Autonomous-Motorsports-Purdue/AMP_PCBv3/(threads)

Thread 2 (2024-04-02):

E-brake motor driver

benjamin-owen, 2024-04-02:
Replace with assembly-compatible part

benjamin-owen, 2024-04-03:
Fixed

Closed 2024-04-03.

Thread 3 (2024-04-02):

Steering

benjamin-owen, 2024-04-02:
Add level shifter for 3.3V-5V logic (see smart air hockey table)

benjamin-owen, 2024-04-03:
Fixed

Closed 2024-04-03.

Thread 4 (2024-04-02):

LEDs

benjamin-owen, 2024-04-02:
Add level shifter for 3.3V-5V logic (see smart air hockey table)

benjamin-owen, 2024-04-03:
Fixed

Closed 2024-04-03.

Thread 6 (2024-04-12):

Remove JLCPCB assembly holes

benjamin-owen, 2024-04-12:
It seems JLC put their own holes on the PCB anyway even though I had already added them, so there is no reason to leave them on the PCB for future orders.

Closed 2024-04-15.

Thread 7 (2024-04-12):

Replace inductor

benjamin-owen, 2024-04-12:
Since JLC doesn't have the SMD power inductor we are using in stock, and we have the room, might as well replace with a large THT inductor for ease of soldering in the future.

benjamin-owen, 2024-04-15:
Due to part availability this isn't feasible.

Closed 2024-04-15.

Thread 10 (2024-04-14):

EBRAKE "+" label wrong?

benjamin-owen, 2024-04-14:
The "+" for EBRAKE might be wrong.  Honestly, can probably just remove it and fix in the EBRAKE driver.

Closed 2024-04-15.

Thread 21 (2024-05-23):

VESC UART driver

benjamin-owen, 2024-05-23:
Good luck (need to reverse engineer VESC code to figure out correct UART commands)
