Autonomous-Motorsports-Purdue/AMP_PCBv3/hardware/AMP_PCBv3.kicad_pcb

## KiCad design hardware/AMP_PCBv3.kicad_pcb (2024-04-04)

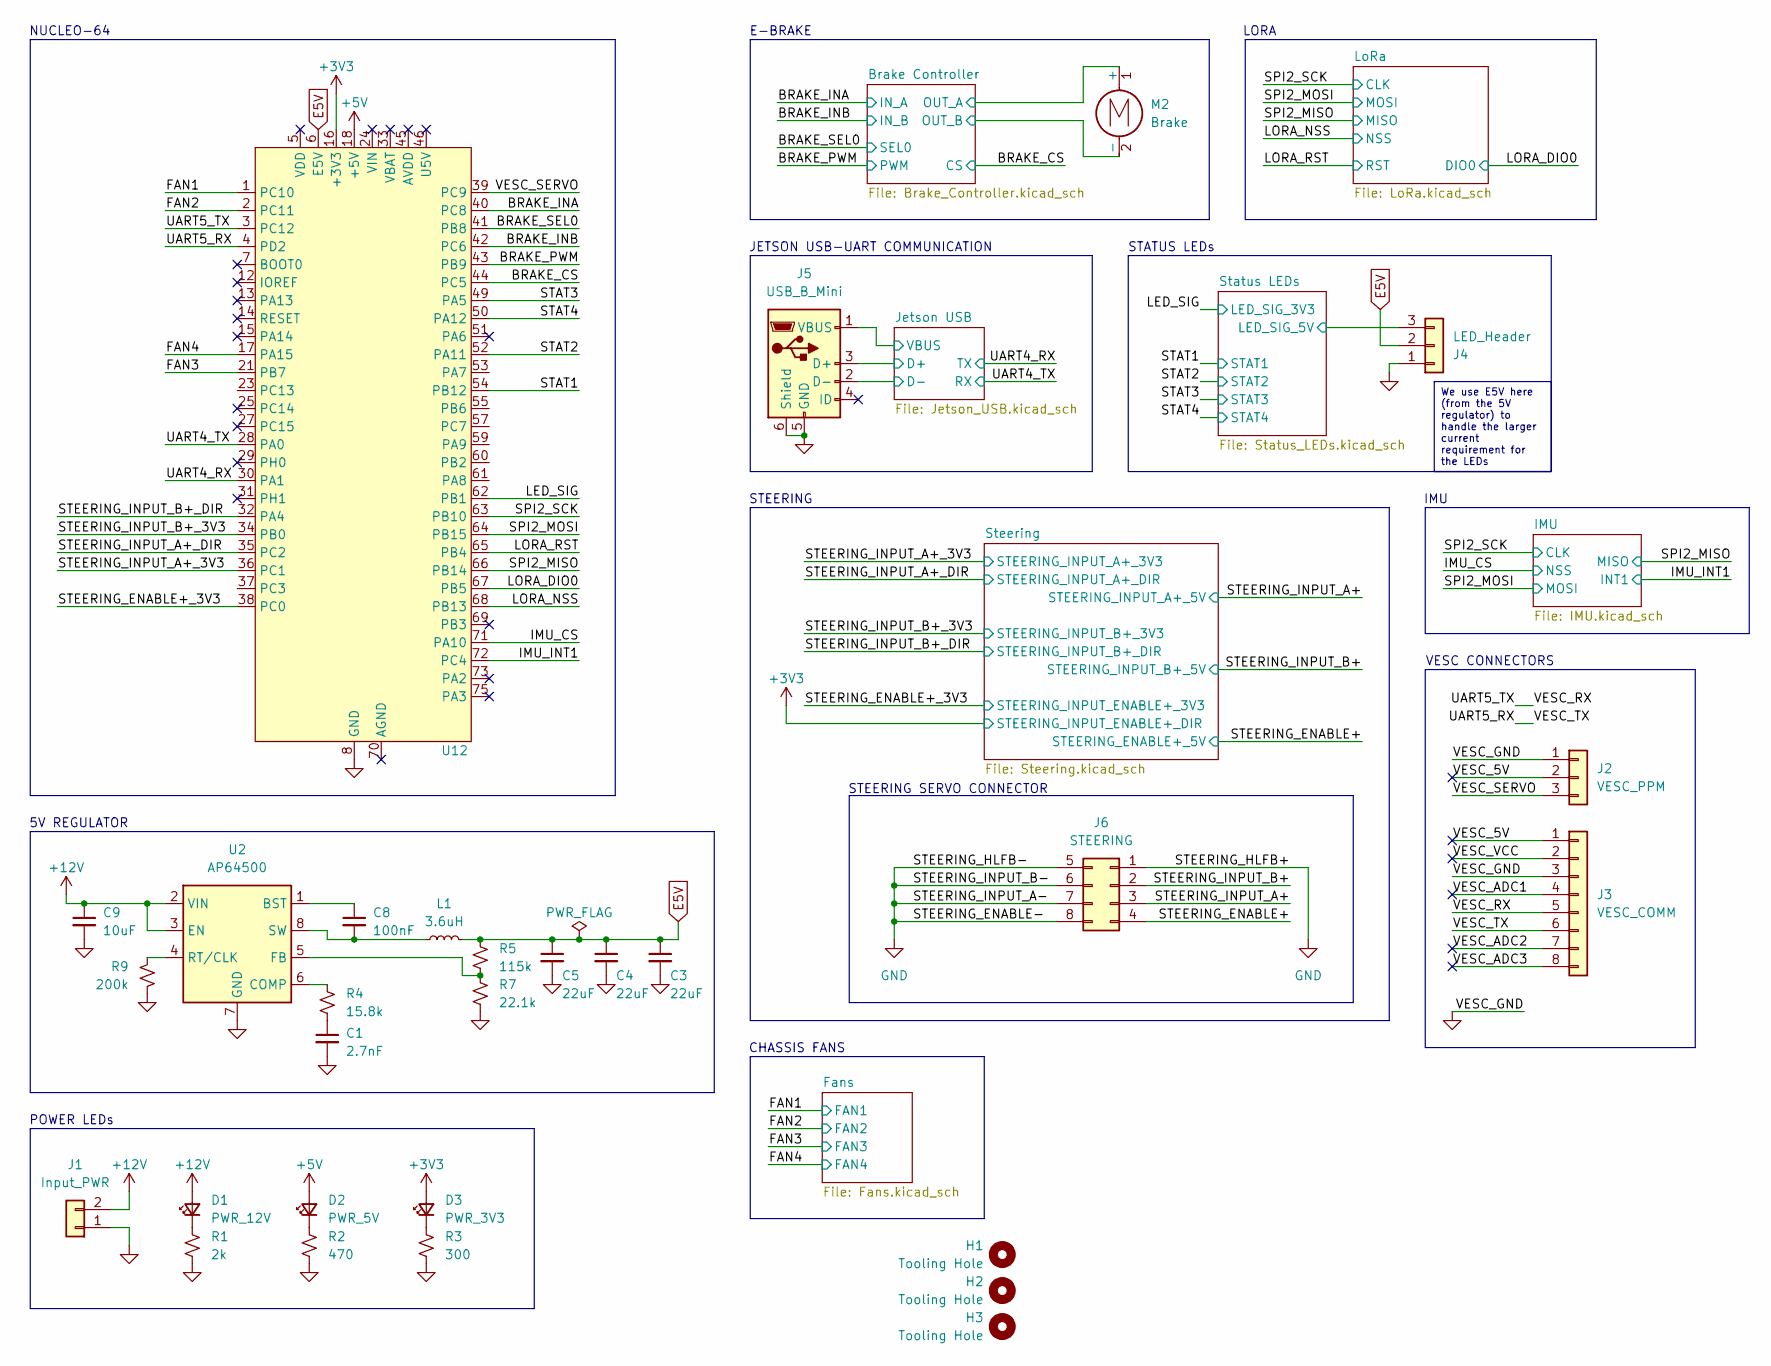
[picture p4: schematic AMP_PCBv3.kicad_sch, AMP PCBv3]

Parts:
C1: 2.7nF; C_0805_2012Metric_Pad1.18x1.45mm_HandSolder; MPN CL21B272KBANNNC
C3, C4, C5: 22uF; C_0805_2012Metric_Pad1.18x1.45mm_HandSolder; JLC C45783
C8: 100nF; C_0805_2012Metric_Pad1.18x1.45mm_HandSolder; JLC C49678
C9: 10uF; C_0805_2012Metric_Pad1.18x1.45mm_HandSolder; JLC C15850
D1: PWR_12V; LED_0805_2012Metric_Pad1.15x1.40mm_HandSolder; JLC C2297
D2: PWR_5V; LED_0805_2012Metric_Pad1.15x1.40mm_HandSolder; JLC C2297
D3: PWR_3V3; LED_0805_2012Metric_Pad1.15x1.40mm_HandSolder; JLC C2297
H1, H2, H3: Tooling Hole; JLCPCB_Tooling_Hole
J1: Input_PWR; Molex_Mini-Fit_Jr_5566-02A_2x01_P4.20mm_Vertical; MPN 0039281023
J2: VESC_PPM; JST_PH_B3B-PH-K_1x03_P2.00mm_Vertical; MPN B3B-PH-K-S
J3: VESC_COMM; JST_PH_B8B-PH-K_1x08_P2.00mm_Vertical; MPN B8B-PH-K-S
J4: LED_Header; Molex_KK-254_AE-6410-03A_1x03_P2.54mm_Vertical; MPN 0022272031
J5: USB_B_Mini; USB_Mini-B_Adam_Tech_MUSB-B5-S-VT-02_Vertical_CircularHoles; MPN MUSB-B5-S-VT-02
J6: STEERING; Molex_Mini-Fit_Jr_5566-08A_2x04_P4.20mm_Vertical; MPN 0039281083
L1: 3.6uH; L_Bourns-SRN8040_8x8.15mm; MPN SRN8040-3R6Y
M2: Brake; Molex_Mini-Fit_Jr_5566-02A_2x01_P4.20mm_Vertical; MPN 0039281023
R1: 2k; R_0805_2012Metric_Pad1.20x1.40mm_HandSolder; JLC C17604
R2: 470; R_0805_2012Metric_Pad1.20x1.40mm_HandSolder; JLC C17710
R3: 300; R_0805_2012Metric_Pad1.20x1.40mm_HandSolder; JLC C17617
R4: 15.8k; R_0805_2012Metric_Pad1.20x1.40mm_HandSolder; MPN RK73H2ATTD1582F
R5: 115k; R_0805_2012Metric_Pad1.20x1.40mm_HandSolder; MPN RC0805FR-07115KL
R7: 22.1k; R_0805_2012Metric_Pad1.20x1.40mm_HandSolder; MPN RMCF0805FT22K1
R9: 200k; R_0805_2012Metric_Pad1.20x1.40mm_HandSolder; JLC C17539
U2: AP64500; Diodes_SO-8EP; JLC C2070920
U12: NUCLEO64

Connections:
+3V3: D3.2 (A), U12.16 (+3V3); also elsewhere on the board
+5V: D2.2 (A), U12.18 (+5V); also elsewhere on the board
+12V: C9.1, D1.2 (A), J1.2, U2.2 (VIN), U2.3 (EN); also elsewhere on the board
/BRAKE_CS: U12.44 (PC5); also elsewhere on the board
/BRAKE_INA: U12.40 (PC8); also elsewhere on the board
/BRAKE_INB: U12.42 (PC6); also elsewhere on the board
/BRAKE_PWM: U12.43 (PB9); also elsewhere on the board
/BRAKE_SEL0: U12.41 (PB8); also elsewhere on the board
/Brake Controller/OUT_A: M2.1 (+); also elsewhere on the board
/Brake Controller/OUT_B: M2.2 (-); also elsewhere on the board
/FAN1: U12.1 (PC10); also elsewhere on the board
/FAN2: U12.2 (PC11); also elsewhere on the board
/FAN3: U12.21 (PB7); also elsewhere on the board
/FAN4: U12.17 (PA15); also elsewhere on the board
/IMU_CS: U12.71 (PA10); also elsewhere on the board
/IMU_INT1: U12.72 (PC4); also elsewhere on the board
/Jetson USB/D+: J5.3 (D+); also elsewhere on the board
/Jetson USB/D-: J5.2 (D-); also elsewhere on the board
/Jetson USB/VBUS: J5.1 (VBUS); also elsewhere on the board
/LED_SIG: U12.62 (PB1); also elsewhere on the board
/LORA_DIO0: U12.67 (PB5); also elsewhere on the board
/LORA_NSS: U12.68 (PB13); also elsewhere on the board
/LORA_RST: U12.65 (PB4); also elsewhere on the board
/SPI2_MISO: U12.66 (PB14); also elsewhere on the board
/SPI2_MOSI: U12.64 (PB15); also elsewhere on the board
/SPI2_SCK: U12.63 (PB10); also elsewhere on the board
/STAT1: U12.54 (PB12); also elsewhere on the board
/STAT2: U12.52 (PA11); also elsewhere on the board
/STAT3: U12.49 (PA5); also elsewhere on the board
/STAT4: U12.50 (PA12); also elsewhere on the board
/STEERING_ENABLE+: J6.4; also elsewhere on the board
/STEERING_ENABLE+_3V3: U12.38 (PC0); also elsewhere on the board
/STEERING_INPUT_A+: J6.3; also elsewhere on the board
/STEERING_INPUT_A+_3V3: U12.36 (PC1); also elsewhere on the board
/STEERING_INPUT_A+_DIR: U12.35 (PC2); also elsewhere on the board
/STEERING_INPUT_B+: J6.2; also elsewhere on the board
/STEERING_INPUT_B+_3V3: U12.34 (PB0); also elsewhere on the board
/STEERING_INPUT_B+_DIR: U12.32 (PA4); also elsewhere on the board
/Status LEDs/LED_SIG_5V: J4.3; also elsewhere on the board
/UART4_RX: U12.30 (PA1); also elsewhere on the board
/UART4_TX: U12.28 (PA0); also elsewhere on the board
/UART5_RX: J3.6, U12.4 (PD2)
/UART5_TX: J3.5, U12.3 (PC12)
/VESC_5V: J2.2, J3.1
/VESC_ADC1: J3.4
/VESC_ADC2: J3.7
/VESC_ADC3: J3.8
/VESC_SERVO: J2.3, U12.39 (PC9)
/VESC_VCC: J3.2
E5V: C3.1, C4.1, C5.1, J4.2, L1.2, R5.1, U12.6 (E5V); also elsewhere on the board
GND: C1.2, C3.2, C4.2, C5.2, C9.2, J1.1, J2.1, J3.3, J4.1, J5.5 (GND), J5.6 (Shield), J6.1, J6.5, J6.6, J6.7, J6.8, R1.2, R2.2, R3.2, R7.2, R9.1, U2.7 (GND), U2.9 (GND), U12.8 (GND), U12.19 (GND), U12.20 (GND), U12.22 (GND), U12.47 (GND), U12.58 (GND); also elsewhere on the board
unnamed: C1.1, R4.1
unnamed: D1.1 (K), R1.1
unnamed: D2.1 (K), R2.1
unnamed: D3.1 (K), R3.1
unnamed: C8.1, U2.1 (BST)
unnamed: R4.2, U2.6 (COMP)
unnamed: R5.2, R7.1, U2.5 (FB)
unnamed: R9.2, U2.4 (RT/CLK)
unnamed: C8.2, L1.1, U2.8 (SW)

Notes on the sheet:
We use E5V here (from the 5V regulator) to handle the larger current requirement for the LEDs
NUCLEO-64
LORA
STEERING SERVO CONNECTOR
E-BRAKE
5V REGULATOR
STEERING
STATUS LEDs
VESC CONNECTORS
POWER LEDs
IMU
CHASSIS FANS
JETSON USB-UART COMMUNICATION

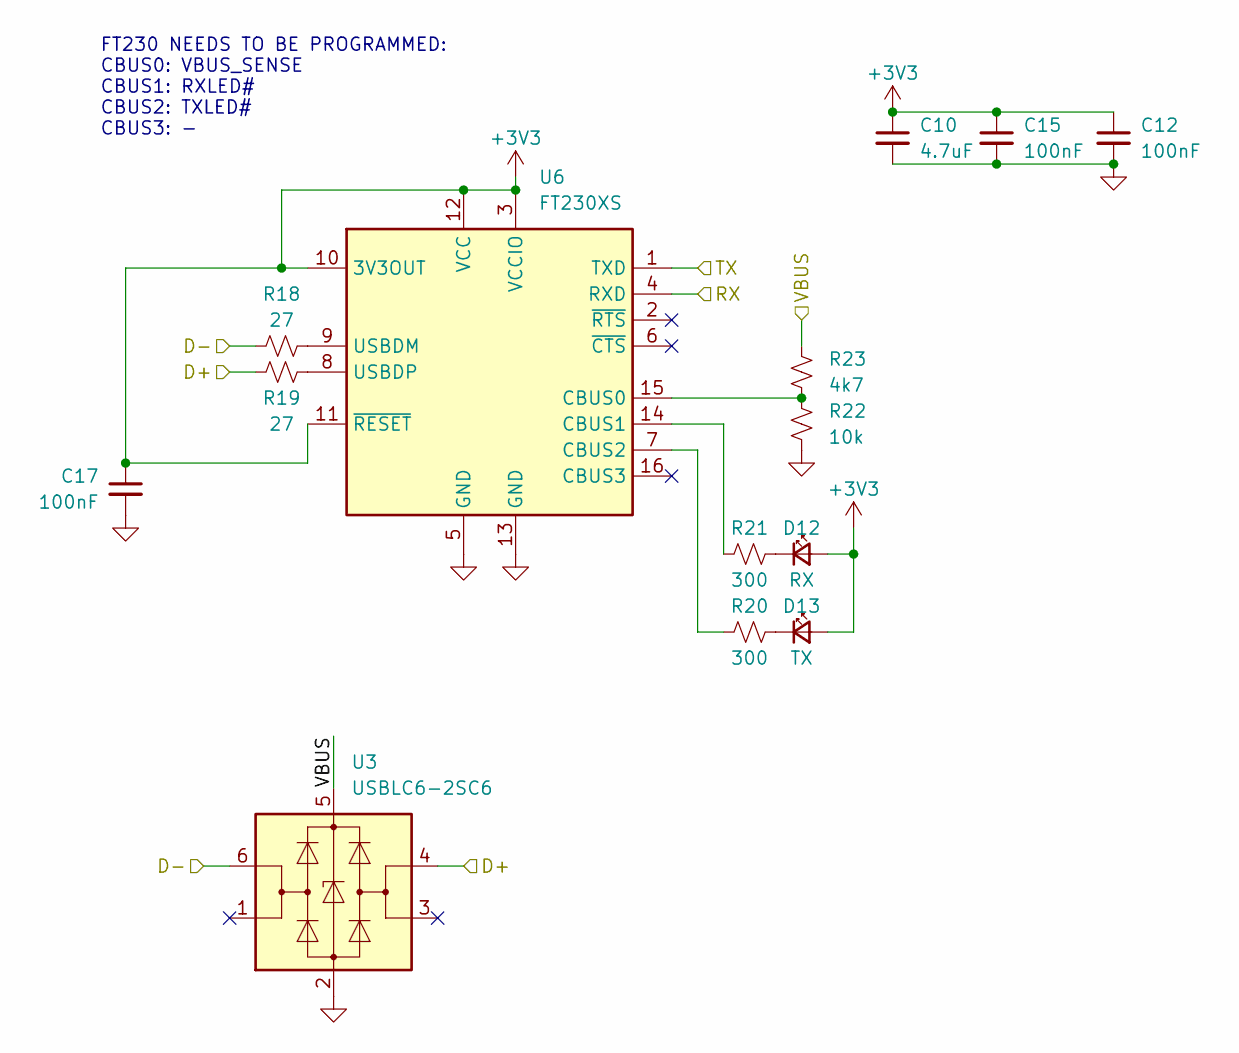
[picture p5: schematic Jetson_USB.kicad_sch, AMP PCBv3]

Parts:
C10: 4.7uF; C_0805_2012Metric_Pad1.18x1.45mm_HandSolder; JLC C1779
C12, C15, C17: 100nF; C_0805_2012Metric_Pad1.18x1.45mm_HandSolder; JLC C49678
D12: RX; LED_0805_2012Metric_Pad1.15x1.40mm_HandSolder; JLC C84256
D13: TX; LED_0805_2012Metric_Pad1.15x1.40mm_HandSolder; JLC C84256
R18, R19: 27; R_0805_2012Metric_Pad1.20x1.40mm_HandSolder; MPN RC0805JR-0727RL
R20, R21: 300; R_0805_2012Metric_Pad1.20x1.40mm_HandSolder; JLC C17617
R22: 10k; R_0805_2012Metric_Pad1.20x1.40mm_HandSolder; JLC C17414
R23: 4k7; R_0805_2012Metric_Pad1.20x1.40mm_HandSolder; JLC C17673
U3: USBLC6-2SC6; SOT-23-6; JLC C2827654
U6: FT230XS; SSOP-16_3.9x4.9mm_P0.635mm; JLC C69082

Connections:
+3V3: C10.1, C12.1, C15.1, C17.1, D12.2 (A), D13.2 (A), U6.3 (VCCIO), U6.10 (3V3OUT), U6.11 (~RESET), U6.12 (VCC); also elsewhere on the board
/Jetson USB/D+: R19.1, U3.4 (I/O2); also elsewhere on the board
/Jetson USB/D-: R18.1, U3.6 (I/O1); also elsewhere on the board
/Jetson USB/VBUS: R23.1, U3.5 (VBUS); also elsewhere on the board
/UART4_RX: U6.1 (TXD); also elsewhere on the board
/UART4_TX: U6.4 (RXD); also elsewhere on the board
GND: C10.2, C12.2, C15.2, C17.2, R22.2, U3.2 (GND), U6.5 (GND), U6.13 (GND); also elsewhere on the board
unnamed: D12.1 (K), R21.2
unnamed: D13.1 (K), R20.2
unnamed: R22.1, R23.2, U6.15 (CBUS0)
unnamed: R21.1, U6.14 (CBUS1)
unnamed: R20.1, U6.7 (CBUS2)
unnamed: R18.2, U6.9 (USBDM)
unnamed: R19.2, U6.8 (USBDP)

Notes on the sheet:
FT230 NEEDS TO BE PROGRAMMED: CBUS0: VBUS_SENSE CBUS1: RXLED# CBUS2: TXLED# CBUS3: -

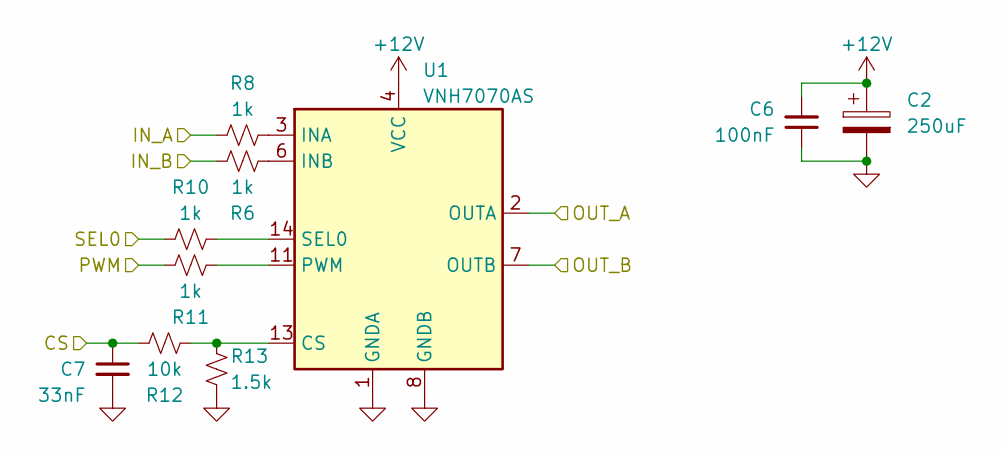
[picture p6: schematic Brake_Controller.kicad_sch, AMP PCBv3]

Parts:
C2: 250uF; CP_Radial_D8.0mm_P3.50mm; MPN A750KS227M1EAAE015
C6: 100nF; C_0805_2012Metric_Pad1.18x1.45mm_HandSolder; JLC C49678
C7: 33nF; C_0805_2012Metric_Pad1.18x1.45mm_HandSolder; JLC C1739
R6, R8, R10, R11: 1k; R_0805_2012Metric_Pad1.20x1.40mm_HandSolder; JLC C17513
R12: 10k; R_0805_2012Metric_Pad1.20x1.40mm_HandSolder; JLC C17414
R13: 1.5k; R_0805_2012Metric_Pad1.20x1.40mm_HandSolder; JLC C4310
U1: VNH7070AS; SOP-16_3.9x9.9mm_P1.27mm; JLC C2150622

Connections:
+12V: C2.1, C6.2, U1.4 (VCC), U1.5 (VCC), U1.12 (VCC); also elsewhere on the board
/BRAKE_CS: C7.1, R12.1; also elsewhere on the board
/BRAKE_INA: R8.1; also elsewhere on the board
/BRAKE_INB: R6.2; also elsewhere on the board
/BRAKE_PWM: R11.2; also elsewhere on the board
/BRAKE_SEL0: R10.1; also elsewhere on the board
/Brake Controller/OUT_A: U1.2 (OUTA), U1.15 (OUTA); also elsewhere on the board
/Brake Controller/OUT_B: U1.7 (OUTB), U1.10 (OUTB); also elsewhere on the board
GND: C2.2, C6.1, C7.2, R13.2, U1.1 (GNDA), U1.8 (GNDB), U1.9 (GNDB), U1.16 (GNDA); also elsewhere on the board
unnamed: R12.2, R13.1, U1.13 (CS)
unnamed: R8.2, U1.3 (INA)
unnamed: R6.1, U1.6 (INB)
unnamed: R11.1, U1.11 (PWM)
unnamed: R10.2, U1.14 (SEL0)

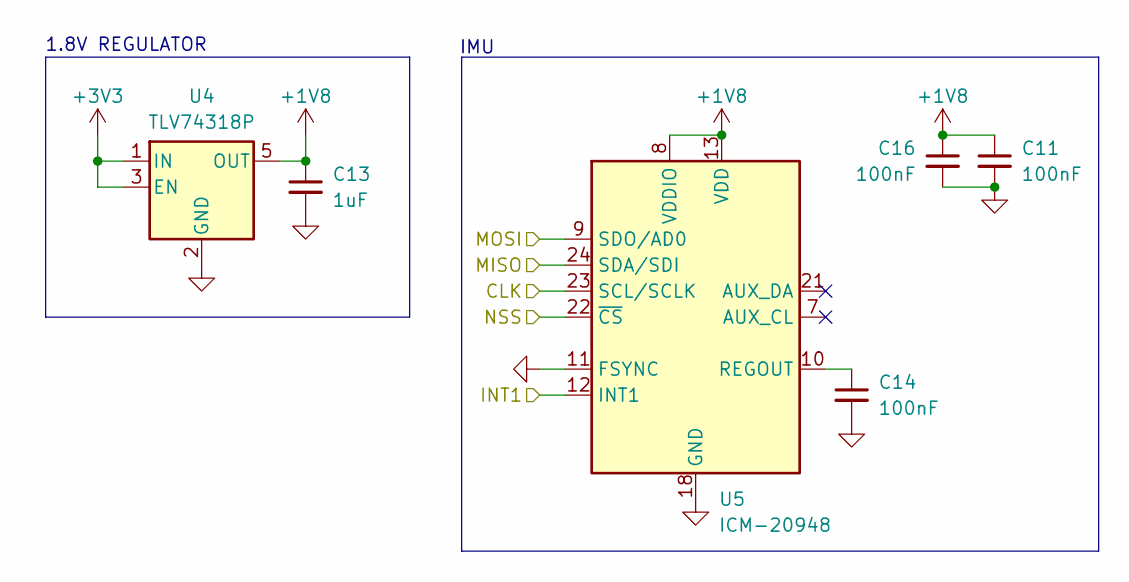
[picture p7: schematic IMU.kicad_sch, AMP PCBv3]

Parts:
C11, C14, C16: 100nF; C_0805_2012Metric_Pad1.18x1.45mm_HandSolder; JLC C49678
C13: 1uF; C_0805_2012Metric_Pad1.18x1.45mm_HandSolder; JLC C28323
U4: TLV74318P; SOT-23-5_HandSoldering; JLC C485152
U5: ICM-20948; InvenSense_QFN-24_3x3mm_P0.4mm; JLC C726001

Connections:
+1V8: C11.1, C13.1, C16.1, U4.5 (OUT), U5.8 (VDDIO), U5.13 (VDD)
+3V3: U4.1 (IN), U4.3 (EN); also elsewhere on the board
/IMU_CS: U5.22 (~CS); also elsewhere on the board
/IMU_INT1: U5.12 (INT1); also elsewhere on the board
/SPI2_MISO: U5.24 (SDA/SDI); also elsewhere on the board
/SPI2_MOSI: U5.9 (SDO/AD0); also elsewhere on the board
/SPI2_SCK: U5.23 (SCL/SCLK); also elsewhere on the board
GND: C11.2, C13.2, C14.2, C16.2, U4.2 (GND), U5.11 (FSYNC), U5.18 (GND), U5.20 (GND); also elsewhere on the board
unnamed: C14.1, U5.10 (REGOUT)

Notes on the sheet:
1.8V REGULATOR
IMU

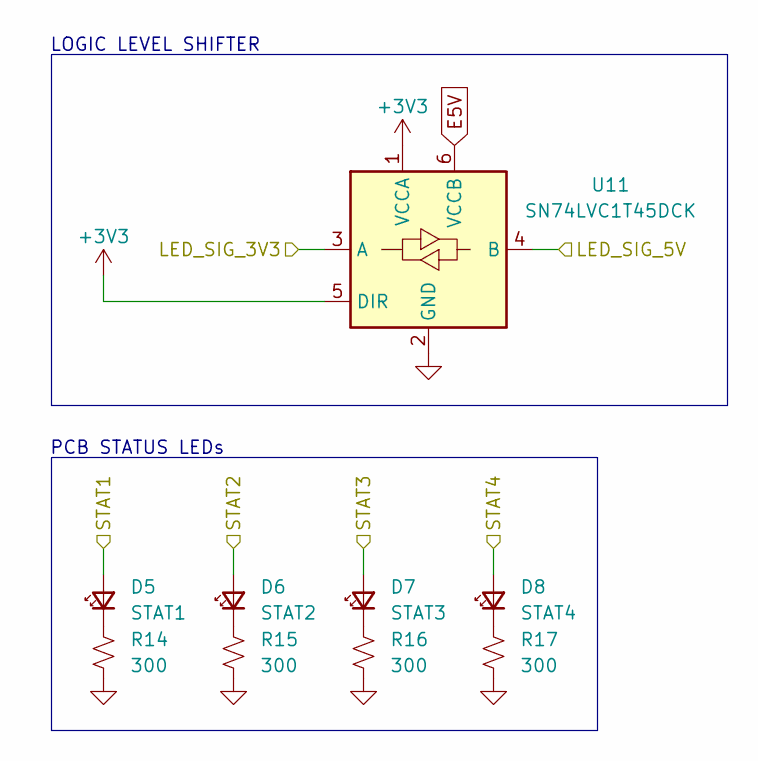
[picture p8: schematic Status_LEDs.kicad_sch, AMP PCBv3]

Parts:
D5: STAT1; LED_0805_2012Metric_Pad1.15x1.40mm_HandSolder; JLC C2296
D6: STAT2; LED_0805_2012Metric_Pad1.15x1.40mm_HandSolder; JLC C2296
D7: STAT3; LED_0805_2012Metric_Pad1.15x1.40mm_HandSolder; JLC C2296
D8: STAT4; LED_0805_2012Metric_Pad1.15x1.40mm_HandSolder; JLC C84256
R14, R15, R16, R17: 300; R_0805_2012Metric_Pad1.20x1.40mm_HandSolder; JLC C17617
U11: SN74LVC1T45DCK; SOT-363_SC-70-6; JLC C9382

Connections:
+3V3: U11.1 (VCCA), U11.5 (DIR); also elsewhere on the board
/LED_SIG: U11.3 (A); also elsewhere on the board
/STAT1: D5.2 (A); also elsewhere on the board
/STAT2: D6.2 (A); also elsewhere on the board
/STAT3: D7.2 (A); also elsewhere on the board
/STAT4: D8.2 (A); also elsewhere on the board
/Status LEDs/LED_SIG_5V: U11.4 (B); also elsewhere on the board
E5V: U11.6 (VCCB); also elsewhere on the board
GND: R14.2, R15.2, R16.2, R17.2, U11.2 (GND); also elsewhere on the board
unnamed: D5.1 (K), R14.1
unnamed: D6.1 (K), R15.1
unnamed: D7.1 (K), R16.1
unnamed: D8.1 (K), R17.1

Notes on the sheet:
LOGIC LEVEL SHIFTER
PCB STATUS LEDs

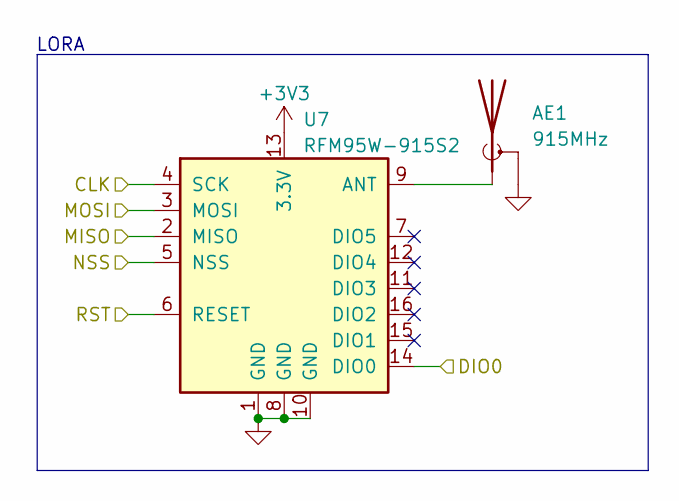
[picture p9: schematic LoRa.kicad_sch, AMP PCBv3]

Parts:
AE1: 915MHz; SMA_Amphenol_132291_Vertical; MPN CONSMA001-C-G
U7: RFM95W-915S2; HOPERF_RFM9XW_SMD; MPN RFM95W-915S2

Connections:
+3V3: U7.13 (3.3V); also elsewhere on the board
/LORA_DIO0: U7.14 (DIO0); also elsewhere on the board
/LORA_NSS: U7.5 (NSS); also elsewhere on the board
/LORA_RST: U7.6 (RESET); also elsewhere on the board
/SPI2_MISO: U7.2 (MISO); also elsewhere on the board
/SPI2_MOSI: U7.3 (MOSI); also elsewhere on the board
/SPI2_SCK: U7.4 (SCK); also elsewhere on the board
GND: AE1.2 (Shield), U7.1 (GND), U7.8 (GND), U7.10 (GND); also elsewhere on the board
unnamed: AE1.1 (A), U7.9 (ANT)

Notes on the sheet:
LORA

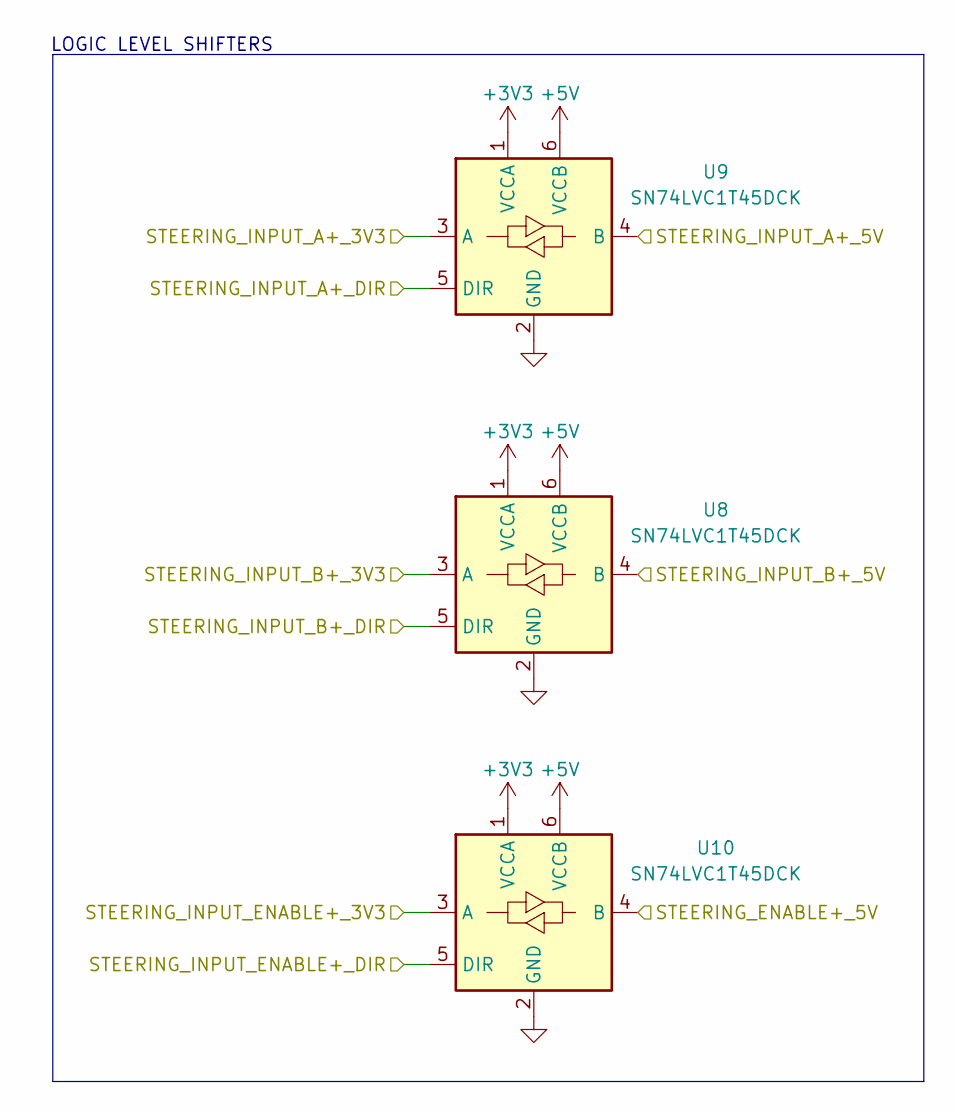
[picture p10: schematic Steering.kicad_sch, AMP PCBv3]

Parts:
U8, U9, U10: SN74LVC1T45DCK; SOT-363_SC-70-6; JLC C9382

Connections:
+3V3: U8.1 (VCCA), U9.1 (VCCA), U10.1 (VCCA), U10.5 (DIR); also elsewhere on the board
+5V: U8.6 (VCCB), U9.6 (VCCB), U10.6 (VCCB); also elsewhere on the board
/STEERING_ENABLE+: U10.4 (B); also elsewhere on the board
/STEERING_ENABLE+_3V3: U10.3 (A); also elsewhere on the board
/STEERING_INPUT_A+: U9.4 (B); also elsewhere on the board
/STEERING_INPUT_A+_3V3: U9.3 (A); also elsewhere on the board
/STEERING_INPUT_A+_DIR: U9.5 (DIR); also elsewhere on the board
/STEERING_INPUT_B+: U8.4 (B); also elsewhere on the board
/STEERING_INPUT_B+_3V3: U8.3 (A); also elsewhere on the board
/STEERING_INPUT_B+_DIR: U8.5 (DIR); also elsewhere on the board
GND: U8.2 (GND), U9.2 (GND), U10.2 (GND); also elsewhere on the board

Notes on the sheet:
LOGIC LEVEL SHIFTERS

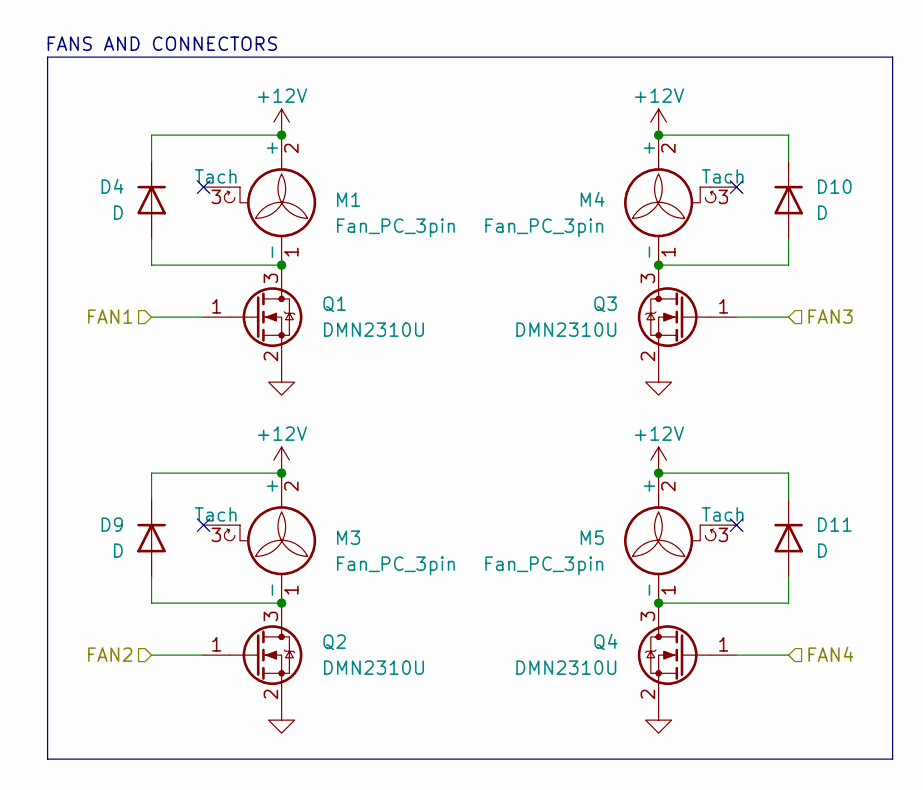
[picture p11: schematic Fans.kicad_sch, AMP PCBv3]

Parts:
D4, D9, D10, D11: D; D_SOD-323F; JLC C2128
M1, M3, M4, M5: Fan_PC_3pin; Molex_KK-254_AE-6410-03A_1x03_P2.54mm_Vertical; MPN 0022272031
Q1, Q2, Q3, Q4: DMN2310U; SOT-23; JLC C20917

Connections:
+12V: D4.1 (K), D9.1 (K), D10.1 (K), D11.1 (K), M1.2 (+), M3.2 (+), M4.2 (+), M5.2 (+); also elsewhere on the board
/FAN1: Q1.1 (G); also elsewhere on the board
/FAN2: Q2.1 (G); also elsewhere on the board
/FAN3: Q3.1 (G); also elsewhere on the board
/FAN4: Q4.1 (G); also elsewhere on the board
GND: Q1.2 (S), Q2.2 (S), Q3.2 (S), Q4.2 (S); also elsewhere on the board
unnamed: D4.2 (A), M1.1 (-), Q1.3 (D)
unnamed: D9.2 (A), M3.1 (-), Q2.3 (D)
unnamed: D10.2 (A), M4.1 (-), Q3.3 (D)
unnamed: D11.2 (A), M5.1 (-), Q4.3 (D)

Notes on the sheet:
FANS AND CONNECTORS

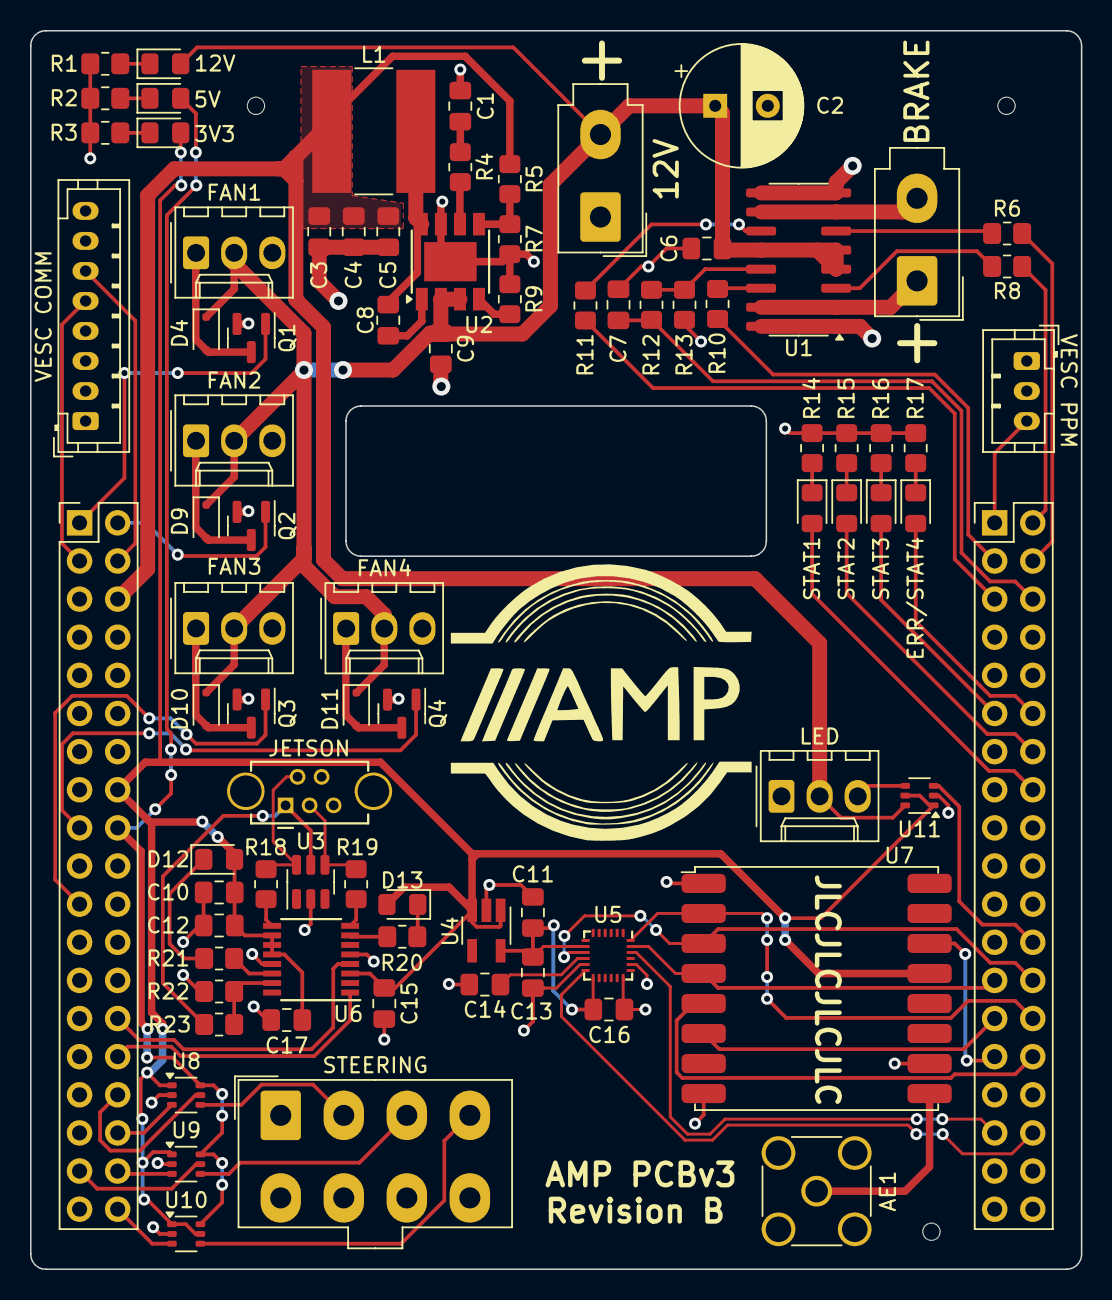
[picture p12: board AMP_PCBv3.kicad_pcb from above]

Board: 2 copper layers, 70.0 x 82.5 mm, 85 parts (0 on the bottom side), 79 nets.
