Autonomous-Motorsports-Purdue/AMP_PCBv3/firmware/AMP_PCBv3/AMP_PCBv3.ioc

Mcu.UserName=STM32F446RETx
PA0-WKUP.Signal=UART4_TX
PA1.Signal=UART4_RX
PA10.GPIO_Label=IMU_CS
PA10.Signal=GPIO_Output
PA11.GPIO_Label=STAT2
PA11.Signal=GPIO_Output
PA12.GPIO_Label=STAT4
PA12.Signal=GPIO_Output
PA13.GPIO_Label=TMS
PA13.Signal=SYS_JTMS-SWDIO
PA14.GPIO_Label=TCK
PA14.Signal=SYS_JTCK-SWCLK
PA15.GPIO_Label=FAN4
PA15.Signal=GPIO_Output
PA2.GPIO_Label=USART_TX
PA2.Signal=USART2_TX
PA3.GPIO_Label=USART_RX
PA3.Signal=USART2_RX
PA4.GPIO_Label=STR_INPUTB+_DIR
PA4.Signal=GPIO_Output
PA5.GPIO_Label=STAT3[GREEN_LED]
PA5.Signal=GPIO_Output
PB0.GPIO_Label=STR_INPUTB+
PB0.Signal=S_TIM3_CH3
PB1.Signal=TIM1_CH3N
PB10.Signal=SPI2_SCK
PB12.GPIO_Label=STAT1
PB12.Signal=GPIO_Output
PB13.GPIO_Label=LORA_NSS
PB13.Signal=GPIO_Output
PB14.Signal=SPI2_MISO
PB15.Signal=SPI2_MOSI
PB3.GPIO_Label=SWO
PB3.Signal=SYS_JTDO-SWO
PB4.GPIO_Label=LORA_RST
PB4.Signal=GPIO_Output
PB5.GPIO_Label=LORA_DIO0
PB5.Signal=GPXTI5
PB6.Signal=S_TIM4_CH1
PB7.GPIO_Label=FAN3
PB7.Signal=GPIO_Output
PB8.GPIO_Label=BRAKE_SEL0
PB8.Signal=GPIO_Output
PB9.GPIO_Label=BRAKE_PWM
PB9.Signal=GPIO_Output
PC0.GPIO_Label=STR_EN+
PC0.Signal=GPIO_Output
PC1.GPIO_Label=STR_INPUTA+
PC1.Signal=GPIO_Output
PC10.GPIO_Label=FAN1
PC10.Signal=GPIO_Output
PC11.GPIO_Label=FAN2
PC11.Signal=GPIO_Output
PC12.Signal=UART5_TX
PC13.GPIO_Label=B1 [BLUE BUTTON]
PC13.Signal=GPXTI13
PC14-OSC32_IN.Signal=RCC_OSC32_IN
PC15-OSC32_OUT.Signal=RCC_OSC32_OUT
PC2.GPIO_Label=STR_INPUTA+_DIR
PC2.Signal=GPIO_Output
PC4.GPIO_Label=IMU_INT1
PC4.Signal=GPXTI4
PC5.GPIO_Label=BRAKE_CS
PC5.Signal=ADCx_IN15
PC6.GPIO_Label=BRAKE_INB
PC6.Signal=GPIO_Output
PC8.GPIO_Label=BRAKE_INA
PC8.Signal=GPIO_Output
PC9.GPIO_Label=VESC_PPM
PC9.Signal=S_TIM8_CH4
PD2.Signal=UART5_RX
PH0-OSC_IN.Signal=RCC_OSC_IN
PH1-OSC_OUT.Signal=RCC_OSC_OUT
