Autonomous-Motorsports-Purdue/AMP_PCBv3/(commit log)

2024-02-09 Add Nucleo headers and rough PCB shape
    [AMP_PCBv3.kicad_pcb, AMP_PCBv3.kicad_sch]
2024-02-10 Add power circuitry and begin routing
    [AMP_PCBv3.kicad_pcb, AMP_PCBv3.kicad_sch]
2024-02-10 Add USB/UART and more routing
    [AMP_PCBv3.kicad_pcb, AMP_PCBv3.kicad_sch, Jetson_USB.kicad_sch]
2024-02-10 Add new brake controller and inductor 3D model
    [AMP_PCBv3.kicad_pcb, AMP_PCBv3.kicad_sch, Brake_Controller.kicad_sch]
2024-02-10 Add IMU schematic
    [AMP_PCBv3.kicad_pcb, AMP_PCBv3.kicad_sch, IMU.kicad_sch]
2024-03-13 Add fan headers and place components
    [AMP_PCBv3.kicad_pcb, AMP_PCBv3.kicad_sch, Jetson_USB.kicad_sch]
2024-03-13 Create STM32 project and map signals in IOC
2024-03-14 Update IOC with steering pins
2024-03-14 Add steering connector and route board (4 layers)
    [AMP_PCBv3.kicad_pcb, AMP_PCBv3.kicad_sch, Jetson_USB.kicad_sch]
2024-04-02 Changes to be updated
    [AMP_PCBv3.kicad_pcb, AMP_PCBv3.kicad_sch, Brake_Controller.kicad_sch, IMU.kicad_sch, Jetson_USB.kicad_sch]
2024-04-02 Resize board and begin new layout
    [AMP_PCBv3-B_Cu.gbl, AMP_PCBv3-B_Mask.gbs, AMP_PCBv3-B_Paste.gbp, AMP_PCBv3-B_Silkscreen.gbo, AMP_PCBv3-Edge_Cuts.gm1, AMP_PCBv3-F_Cu.gtl, AMP_PCBv3-F_Mask.gts, AMP_PCBv3-F_Paste.gtp]
2024-04-02 Add level shifters
    [AMP_PCBv3.kicad_pcb, AMP_PCBv3.kicad_sch]
2024-04-03 Place and route
    [AMP_PCBv3.kicad_pcb, AMP_PCBv3.kicad_sch, Brake_Controller.kicad_sch]
2024-04-03 Add level shifter for LEDs
    [AMP_PCBv3.kicad_pcb, AMP_PCBv3.kicad_sch, Brake_Controller.kicad_sch, IMU.kicad_sch, Jetson_USB.kicad_sch]
2024-04-03 JLC assembly parts
    [AMP_PCBv3.kicad_pcb, AMP_PCBv3.kicad_sch, Brake_Controller.kicad_sch, IMU.kicad_sch, Jetson_USB.kicad_sch]
2024-04-03 Schematic cleanup
    [AMP_PCBv3.kicad_pcb, AMP_PCBv3.kicad_sch, Brake_Controller.kicad_sch, Fans.kicad_sch, IMU.kicad_sch, Jetson_USB.kicad_sch, LoRa.kicad_sch, Status_LED.kicad_sch]
2024-04-03 Final touches for assembly
    [AMP_PCBv3.kicad_pcb, AMP_PCBv3.kicad_sch, IMU.kicad_sch, Jetson_USB.kicad_sch, Status_LEDs.kicad_sch]
2024-04-14 fan functions added
2024-04-19 Change existing driver format and setup state machine skeleton
2024-04-19 Remove some fan driver functions
2024-04-19 Add status LED driver
2024-04-22 started steering PWM
2024-04-22 Add steering functions and fix duty cycle
    [AMP_PCBv3.ioc, app_statemachine.c, driver_steering.c, main.h]
2024-04-22 Fix errors from merge
    [AMP_PCBv3.ioc, app_statemachine.c]
2024-04-22 Fix UART bug where too long input would infinite loop
    [app_statemachine.c]
2024-04-23 Rename status LED driver to debug LED driver
2024-04-23 Rename debug LED driver
2024-04-23 Fix pin assignments
2024-04-24 Add throttle driver
2024-04-24 Add ability to enter negative throttle in console mode
2024-04-29 Update throttle value every tick
2024-05-01 Extend the e-brake during init to avoid long-term damage
    [driver_ebrake.c]
