Autonomous-Motorsports-Purdue/AMP_PCBv3/(notices)

Notices in the files:
firmware/AMP_PCBv3/Core/Inc/main.h:
Copyright (c) 2024 STMicroelectronics.
All rights reserved.
This software is licensed under terms that can be found in the LICENSE file
